NickRimmer/RedBot/README.md

# RedBot

Please check [this site](https://www.redbot.info/pages/en/welcome/) for more information.

Более подробную информацию вы можете найти [на этом сайте](https://www.redbot.info/pages/en/welcome/).
