NickRimmer/RedBot/printers/re_d_bot_v1/mods/mgn12_y_axis/main.stl

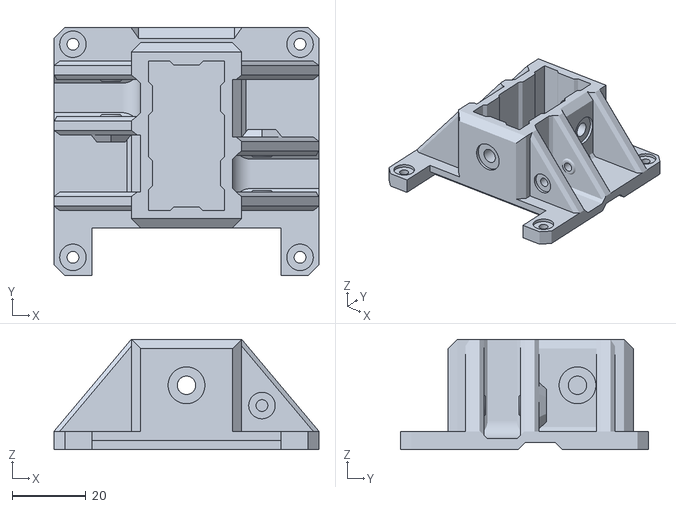
[picture p1: CAD file, 2018-05-23]
printers/re_d_bot_v1/mods/mgn12_y_axis/main.stl
72.0 x 67.5 x 30.0
