NickRimmer/RedBot/printers/re_d_bot_v1/base/1_Endstop_x_flange.STL

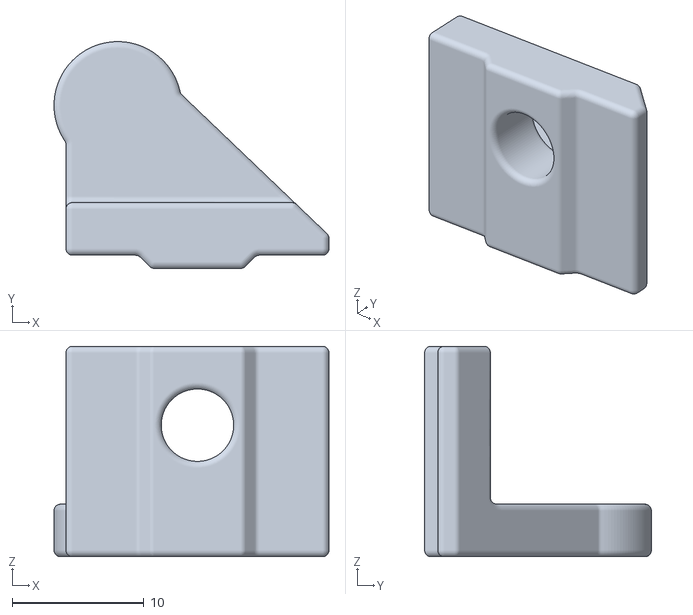
[picture p2: CAD file, 2018-05-17]
printers/re_d_bot_v1/base/1_Endstop_x_flange.STL
20.9 x 17.2 x 16.0
