NickRimmer/RedBot/printers/re_d_bot_v1/base/head/E3Dv6_holder_part2.STL

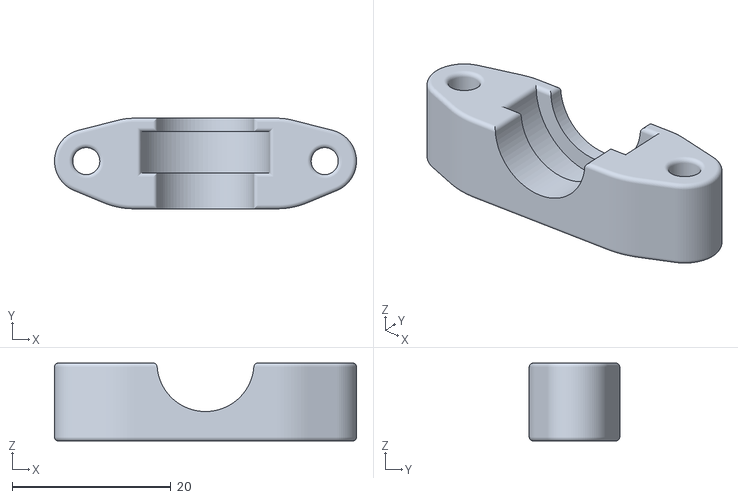
[picture p3: CAD file, 2018-05-17]
printers/re_d_bot_v1/base/head/E3Dv6_holder_part2.STL
38.0 x 11.4 x 9.80
