NickRimmer/RedBot/printers/re_d_bot_v1/mods/mgn12_y_axis/top.stl

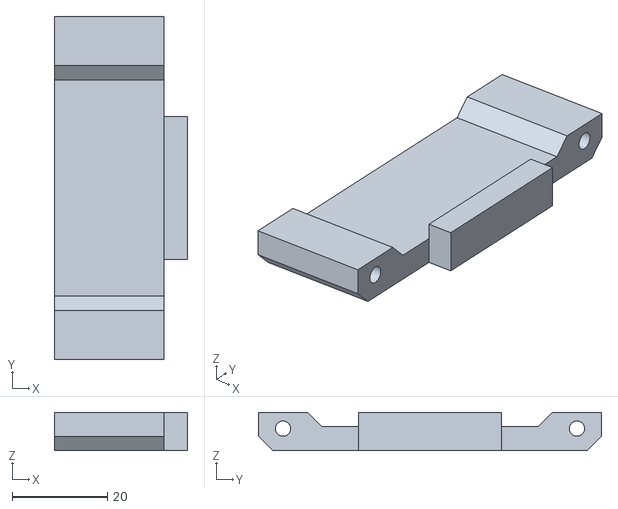
[picture p4: CAD file, 2018-05-23]
printers/re_d_bot_v1/mods/mgn12_y_axis/top.stl
28.0 x 72.0 x 8.00
