NickRimmer/RedBot/printers/re_d_bot_v1/mods/re_x_carriage/Base_back_1.STL

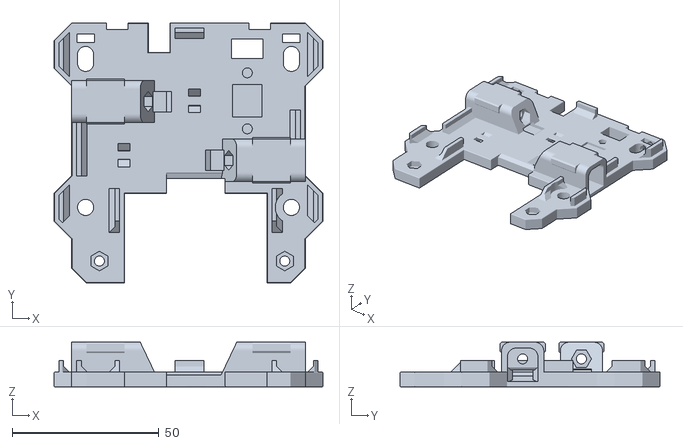
[picture p5: CAD file, 2018-05-20]
printers/re_d_bot_v1/mods/re_x_carriage/Base_back_1.STL
91.5 x 88.5 x 15.2
