NickRimmer/RedBot/printers/re_d_bot_v1/base/4_Triangle_table_plate_mirrored.STL

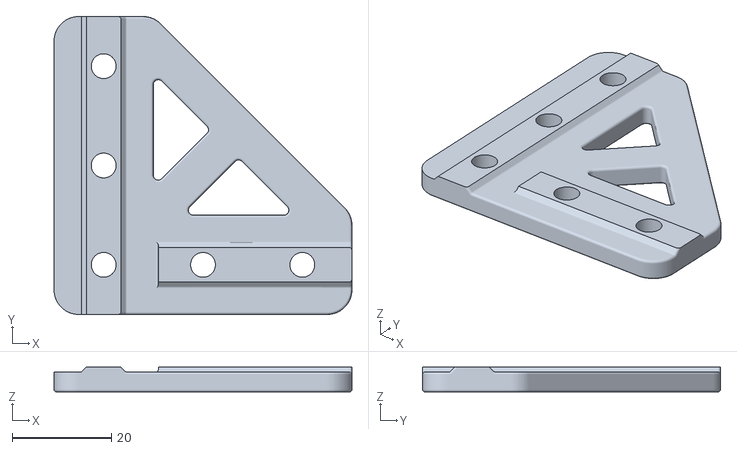
[picture p6: CAD file, 2018-05-17]
printers/re_d_bot_v1/base/4_Triangle_table_plate_mirrored.STL
60.0 x 60.0 x 5.00
