NickRimmer/RedBot/printers/re_d_bot_v1/base/head/Carriage_base_front.STL

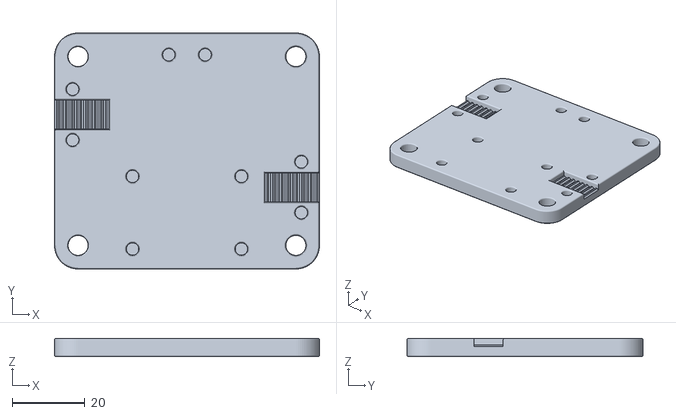
[picture p7: CAD file, 2018-05-17]
printers/re_d_bot_v1/base/head/Carriage_base_front.STL
73.0 x 65.0 x 5.00
