NickRimmer/RedBot/printers/re_d_bot_v1/mods/mgn12_y_axis/back.stl

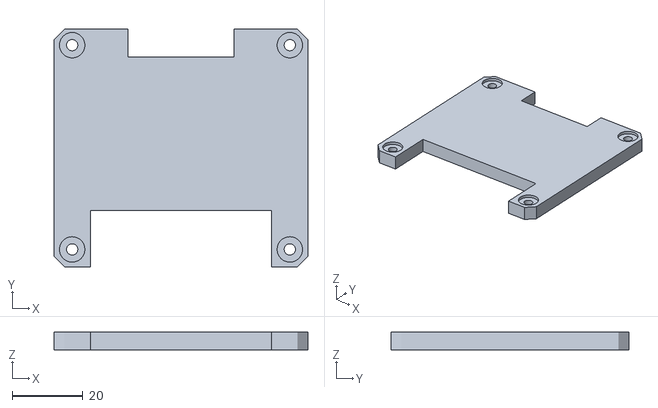
[picture p8: CAD file, 2018-05-23]
printers/re_d_bot_v1/mods/mgn12_y_axis/back.stl
72.0 x 67.5 x 5.00
