NickRimmer/RedBot/printers/re_d_bot_v1/mods/re_x_carriage/fan_duct_filament_nozzle_left.sldprt

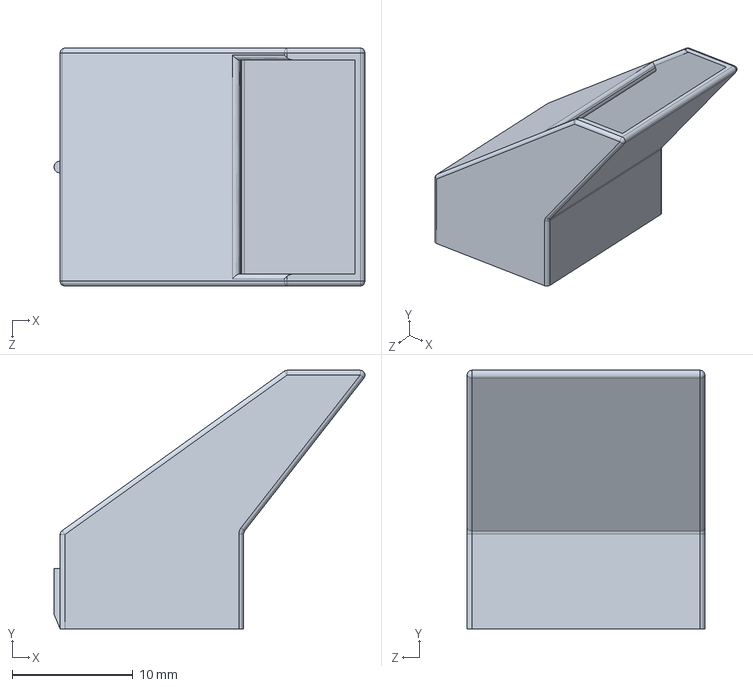
[picture p9: CAD file, 2018-05-20]
printers/re_d_bot_v1/mods/re_x_carriage/fan_duct_filament_nozzle_left.sldprt
25.7 x 21.4 x 19.7 mm
