NickRimmer/RedBot/printers/re_d_bot_v1/base/1_Endstop_z_base_part1.STL

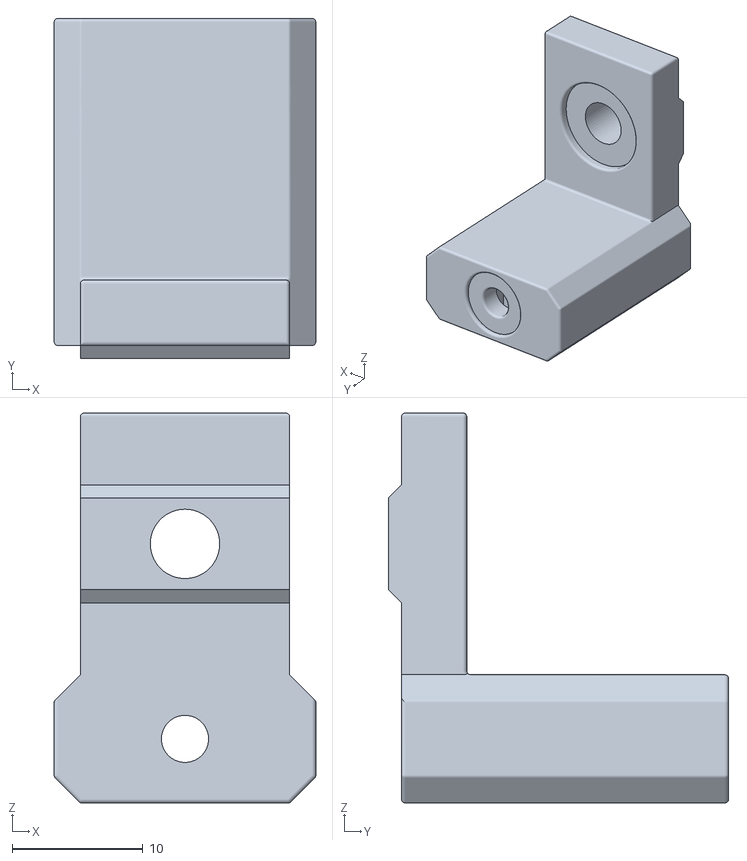
[picture p10: CAD file, 2018-05-17]
printers/re_d_bot_v1/base/1_Endstop_z_base_part1.STL
20.0 x 26.0 x 29.8
