NickRimmer/RedBot/printers/re_d_bot_v1/base/head/Decorative_Cover_front_part3.STL

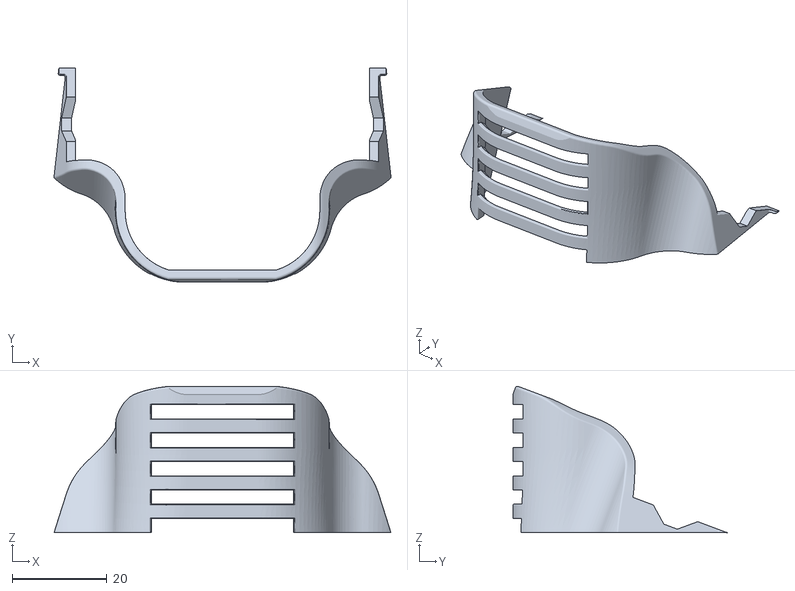
[picture p11: CAD file, 2018-05-17]
printers/re_d_bot_v1/base/head/Decorative_Cover_front_part3.STL
71.0 x 45.2 x 30.9
