NickRimmer/RedBot/printers/re_d_bot_v1/mods/mgn12_y_axis/bottom.stl

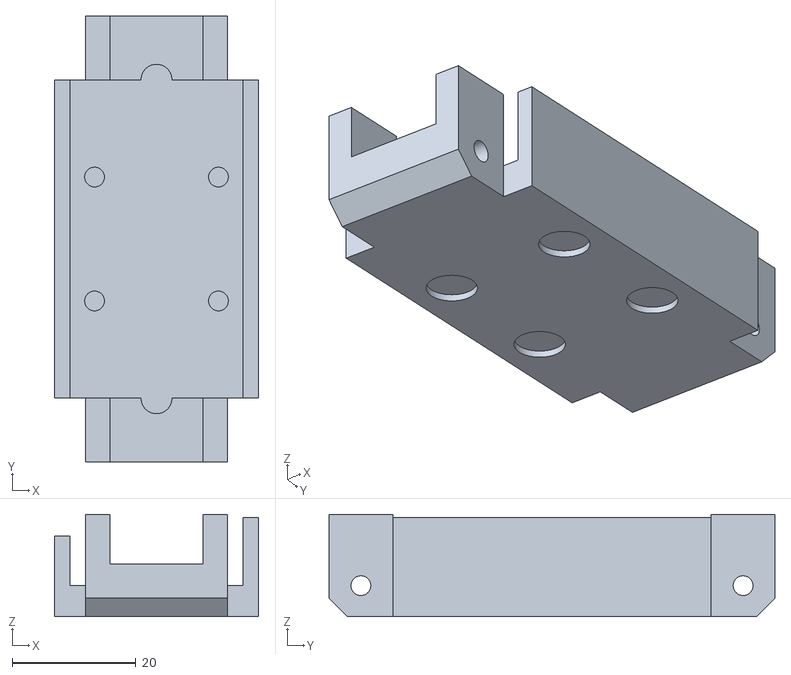
[picture p12: CAD file, 2018-05-23]
printers/re_d_bot_v1/mods/mgn12_y_axis/bottom.stl
33.0 x 72.0 x 16.5
