NickRimmer/RedBot/printers/re_d_bot_v1/mods/re_x_carriage/Belt_holder_back_2.STL

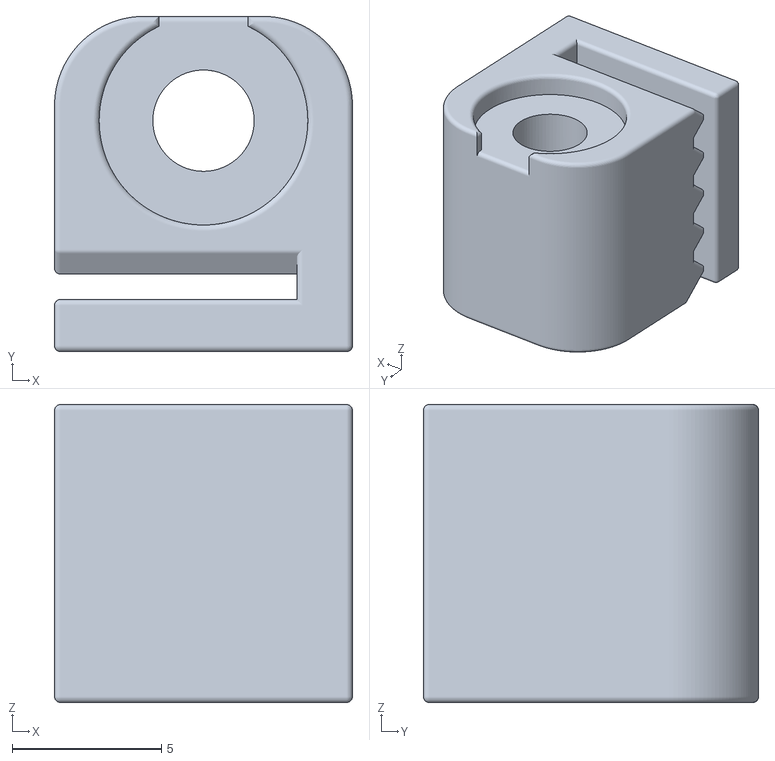
[picture p13: CAD file, 2018-05-20]
printers/re_d_bot_v1/mods/re_x_carriage/Belt_holder_back_2.STL
10.00 x 11.2 x 10.00
