NickRimmer/RedBot/printers/re_d_bot_v1/base/2_Z_motor_mount.STL

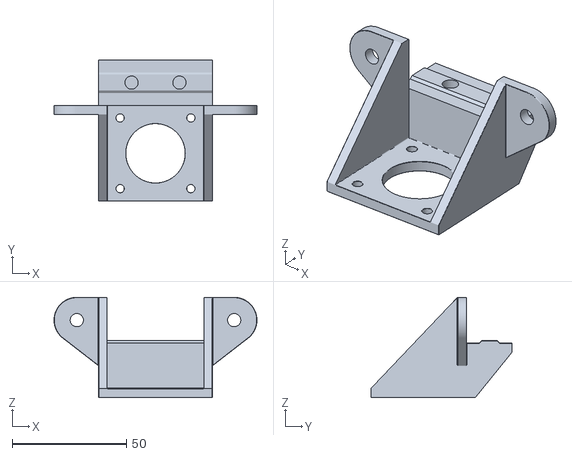
[picture p14: CAD file, 2018-05-17]
printers/re_d_bot_v1/base/2_Z_motor_mount.STL
89.0 x 62.0 x 44.0
