NickRimmer/RedBot/printers/re_d_bot_v1/base/head/Fan_duct_filament_V2.STL

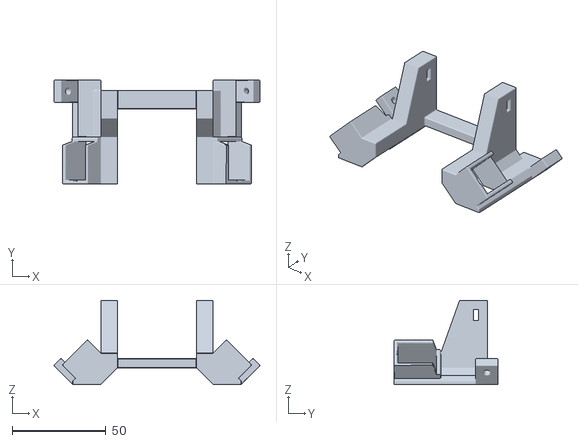
[picture p15: CAD file, 2018-05-17]
printers/re_d_bot_v1/base/head/Fan_duct_filament_V2.STL
110.0 x 55.5 x 45.0
