NickRimmer/RedBot/printers/re_d_bot_v1/base/4_Guide_Z.STL

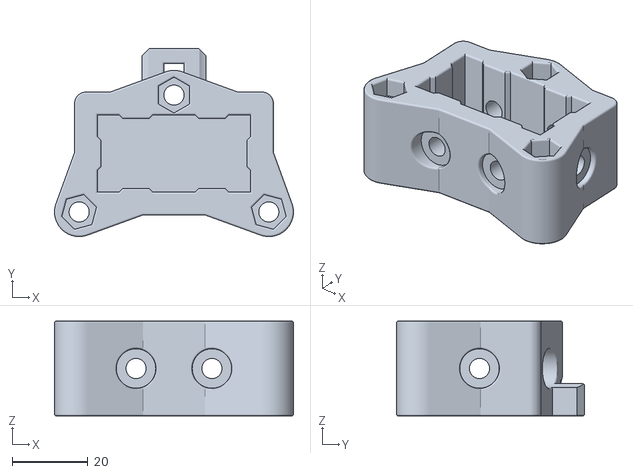
[picture p16: CAD file, 2018-05-17]
printers/re_d_bot_v1/base/4_Guide_Z.STL
63.0 x 49.6 x 25.0
