NickRimmer/RedBot/printers/re_d_bot_v1/base/head/fan_duct_filament_V2_nozzle.sldprt

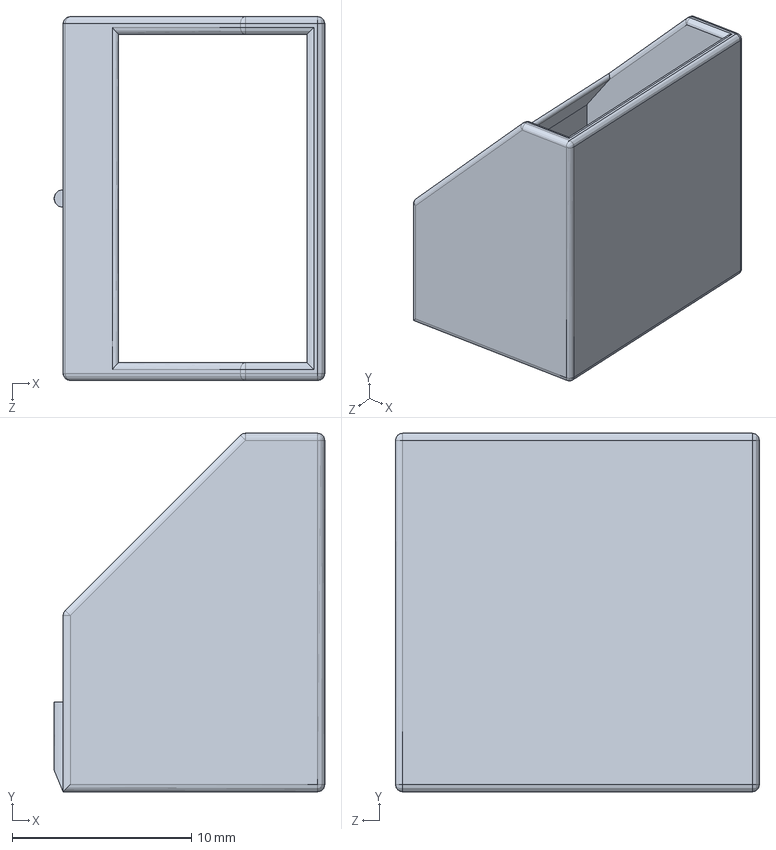
[picture p17: CAD file, 2018-05-17]
printers/re_d_bot_v1/base/head/fan_duct_filament_V2_nozzle.sldprt
15.1 x 20.0 x 20.3 mm
