NickRimmer/RedBot/printers/re_d_bot_v1/base/1_Guide_Y_right.STL

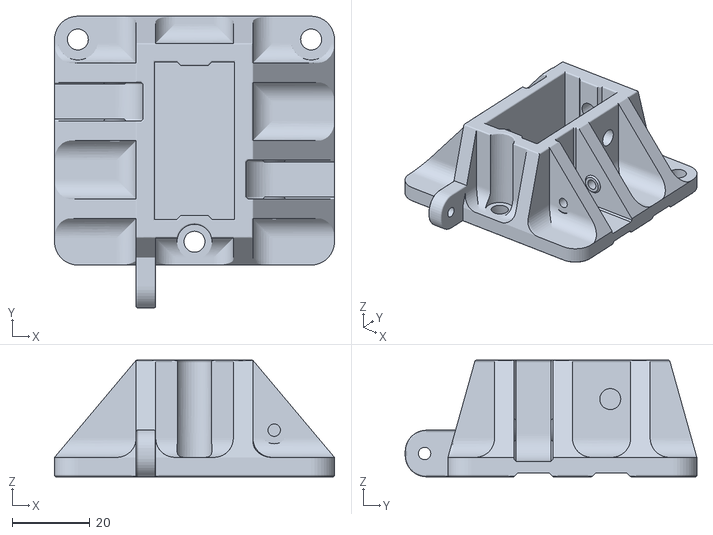
[picture p18: CAD file, 2018-05-17]
printers/re_d_bot_v1/base/1_Guide_Y_right.STL
72.0 x 75.0 x 30.0
