NickRimmer/RedBot/printers/re_d_bot_v1/base/head/Carriage_base_back.STL

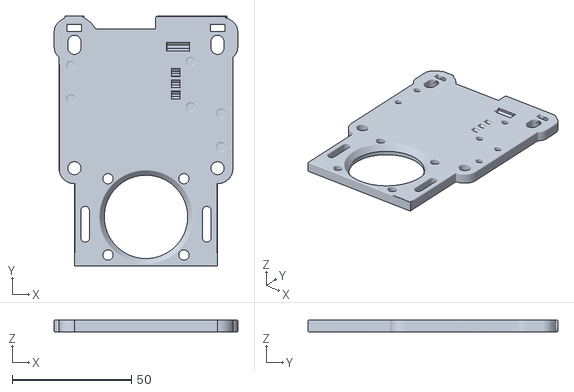
[picture p19: CAD file, 2018-05-17]
printers/re_d_bot_v1/base/head/Carriage_base_back.STL
77.0 x 104.8 x 5.00
