NickRimmer/RedBot/printers/re_d_bot_v1/base/22_(IF_REQUIRED)_Bearing_Shim.stl

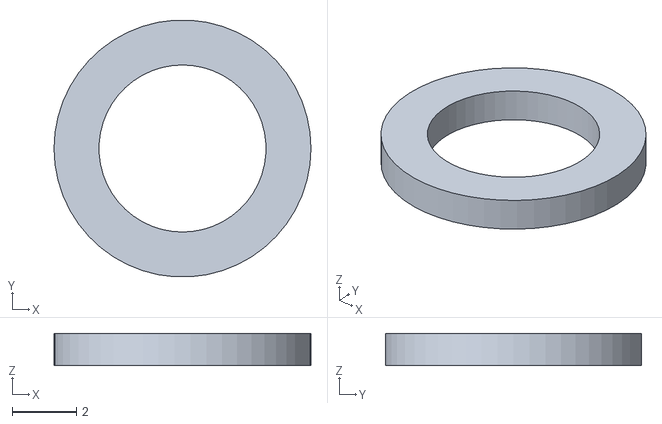
[picture p21: CAD file, 2018-05-17]
printers/re_d_bot_v1/base/22_(IF_REQUIRED)_Bearing_Shim.stl
8.00 x 7.98 x 1
