NickRimmer/RedBot/printers/re_d_bot_v1/mods/re_x_carriage/Endstop_x_part2_1.STL

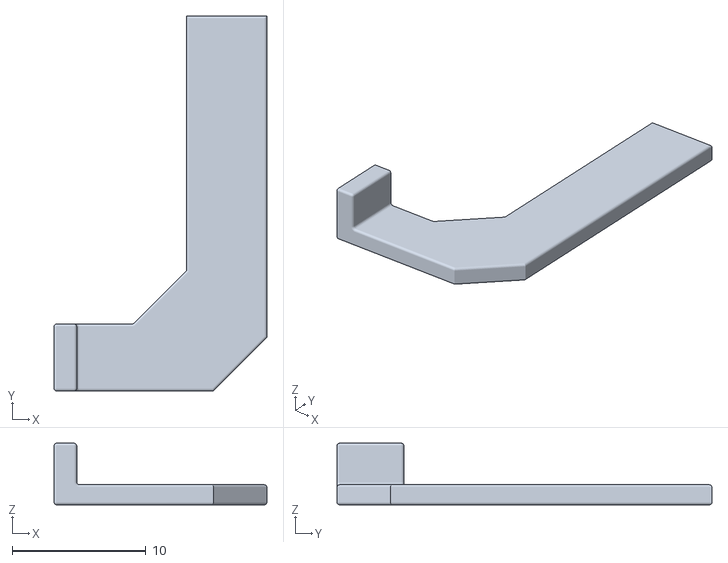
[picture p22: CAD file, 2018-05-20]
printers/re_d_bot_v1/mods/re_x_carriage/Endstop_x_part2_1.STL
15.9 x 28.0 x 4.60
