NickRimmer/RedBot/printers/re_d_bot_v1/base/1_Extruder_motor_holder.STL

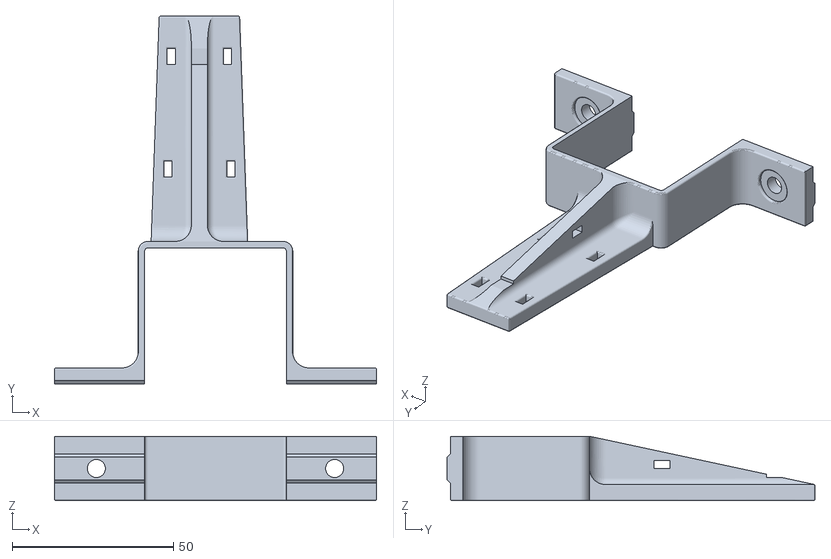
[picture p23: CAD file, 2018-05-17]
printers/re_d_bot_v1/base/1_Extruder_motor_holder.STL
100.0 x 114.2 x 20.0
