NickRimmer/RedBot/printers/re_d_bot_v1/mods/re_x_carriage/Fan_duct_filament_holder_1.STL

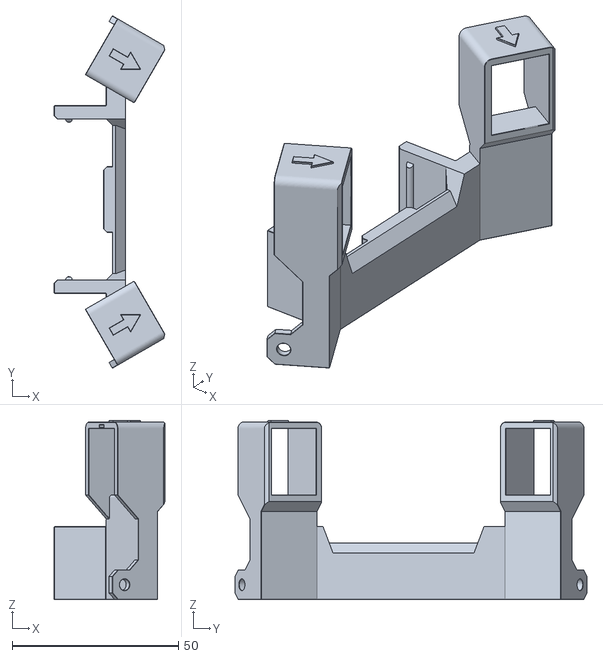
[picture p25: CAD file, 2018-05-20]
printers/re_d_bot_v1/mods/re_x_carriage/Fan_duct_filament_holder_1.STL
33.3 x 105.7 x 53.9
