NickRimmer/RedBot/printers/re_d_bot_v1/base/1_Endstop_y_bracket.STL

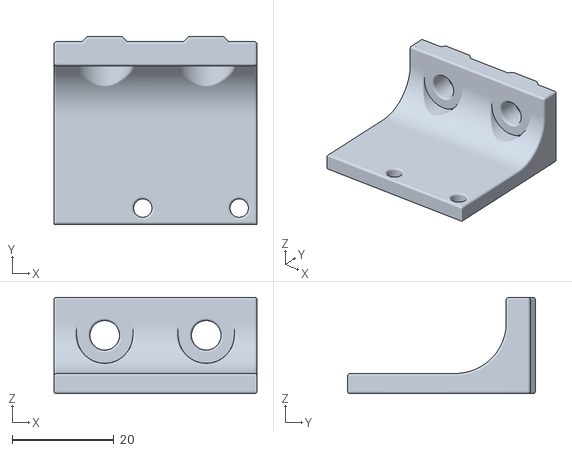
[picture p26: CAD file, 2018-05-17]
printers/re_d_bot_v1/base/1_Endstop_y_bracket.STL
40.0 x 37.0 x 19.0
