NickRimmer/RedBot/printers/re_d_bot_v1/base/head/Decorative_Cover_rear.STL

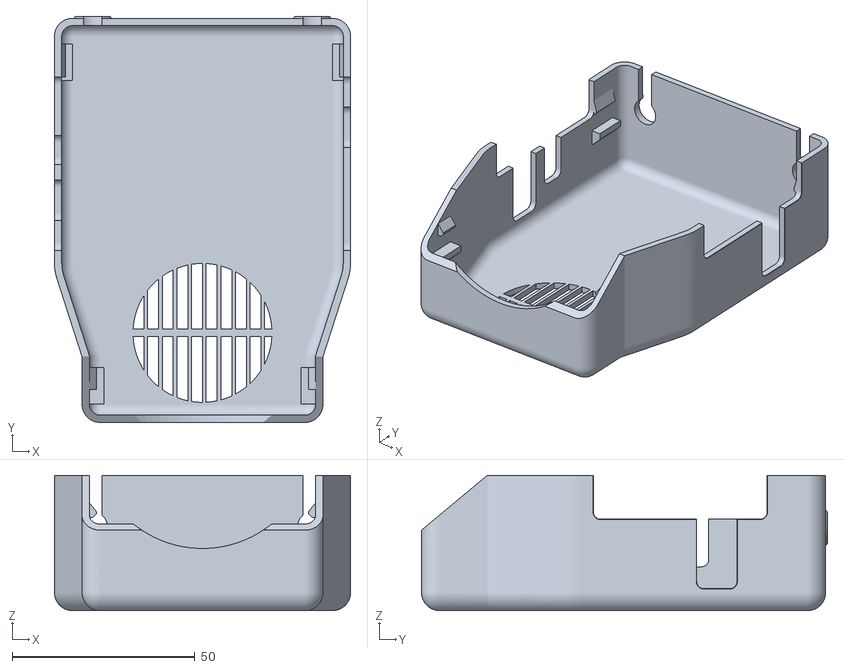
[picture p27: CAD file, 2018-05-17]
printers/re_d_bot_v1/base/head/Decorative_Cover_rear.STL
81.0 x 111.0 x 37.0
