NickRimmer/RedBot/printers/re_d_bot_v1/mods/re_x_carriage/Cover_top_1.STL

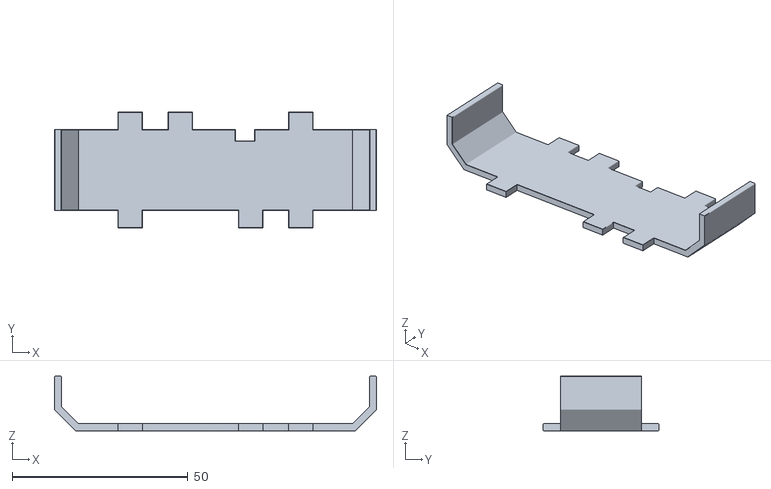
[picture p28: CAD file, 2018-05-20]
printers/re_d_bot_v1/mods/re_x_carriage/Cover_top_1.STL
91.5 x 33.0 x 15.5
