NickRimmer/RedBot/printers/re_d_bot_v1/base/head/updated_Decorative_Cover_front_part1_no_title.STL

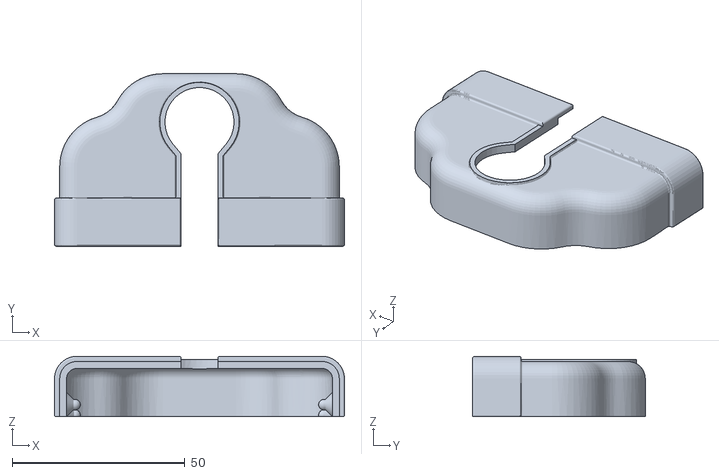
[picture p30: CAD file, 2018-05-17]
printers/re_d_bot_v1/base/head/updated_Decorative_Cover_front_part1_no_title.STL
84.0 x 50.0 x 17.5
