NickRimmer/RedBot/printers/re_d_bot_v1/mods/re_x_carriage/fan_duct_filament_nozzle_right.sldprt

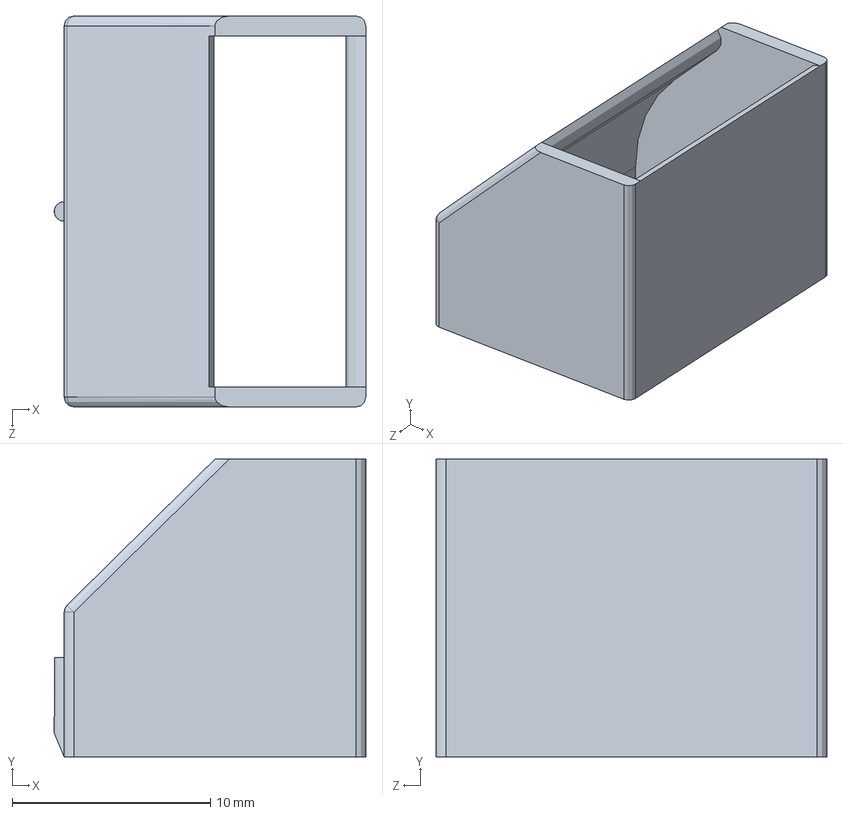
[picture p31: CAD file, 2018-05-20]
printers/re_d_bot_v1/mods/re_x_carriage/fan_duct_filament_nozzle_right.sldprt
15.7 x 15.0 x 19.7 mm
