NickRimmer/RedBot/printers/re_d_bot_v1/base/3_Bed_holder_part2.STL

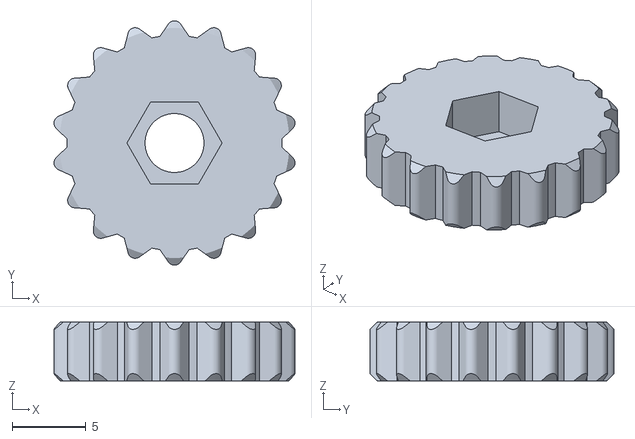
[picture p32: CAD file, 2018-05-17]
printers/re_d_bot_v1/base/3_Bed_holder_part2.STL
16.4 x 16.6 x 4.00
