NickRimmer/RedBot/printers/re_d_bot_v1/base/head/E3Dv6_holder_part1.STL

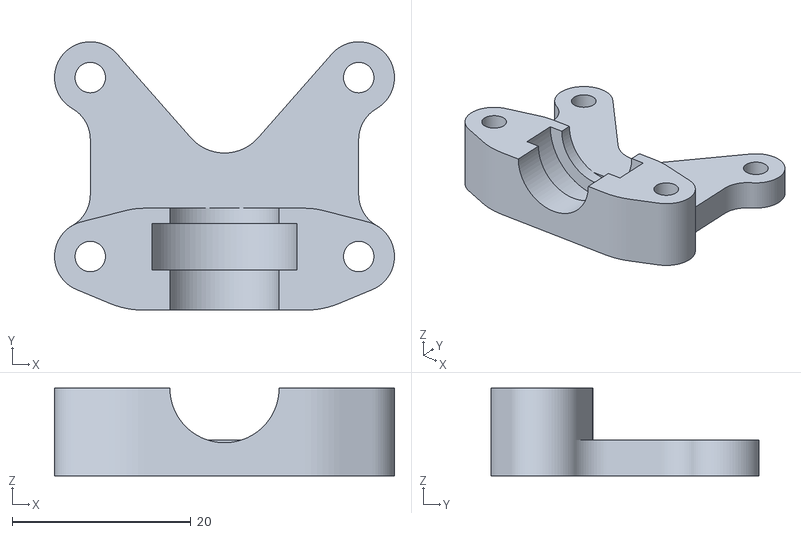
[picture p33: CAD file, 2018-05-17]
printers/re_d_bot_v1/base/head/E3Dv6_holder_part1.STL
38.0 x 30.0 x 9.80
