NickRimmer/RedBot/printers/re_d_bot_v1/base/2_Guide_Y_part2.STL

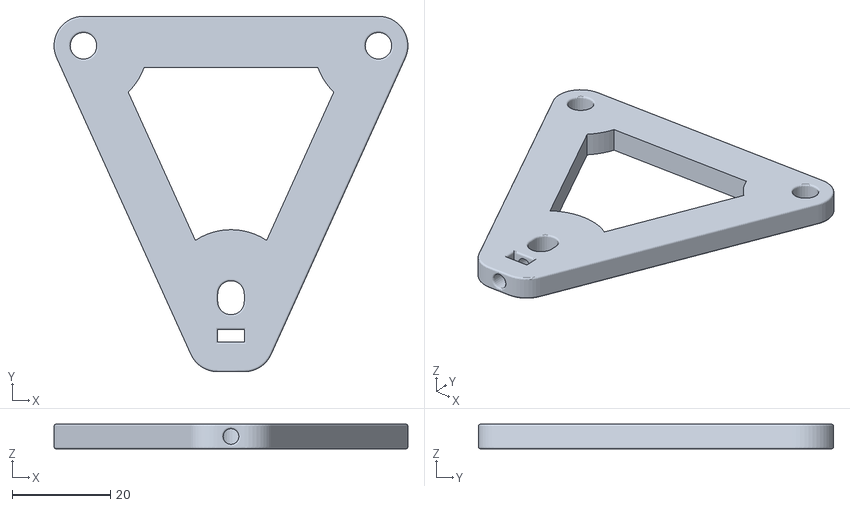
[picture p34: CAD file, 2018-05-17]
printers/re_d_bot_v1/base/2_Guide_Y_part2.STL
72.0 x 72.3 x 5.00
