NickRimmer/RedBot/printers/re_d_bot_v1/base/head/PTFE_Guide.STL

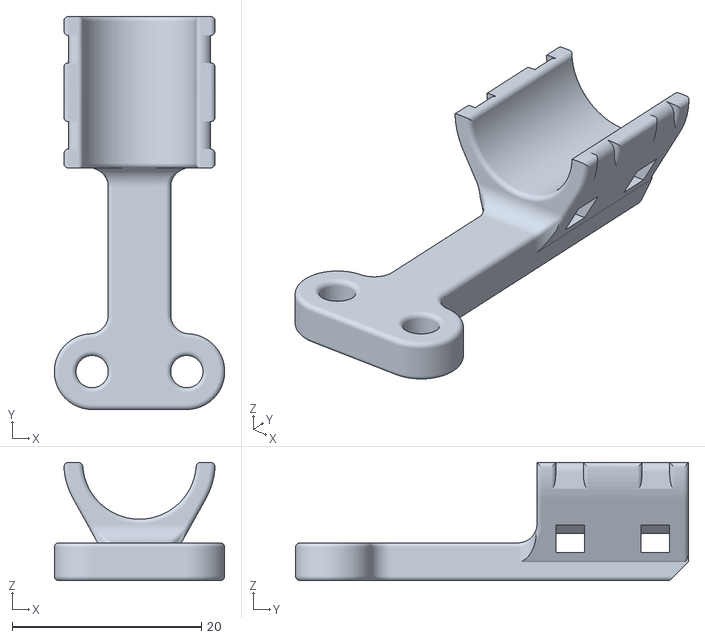
[picture p35: CAD file, 2018-05-17]
printers/re_d_bot_v1/base/head/PTFE_Guide.STL
18.0 x 41.5 x 12.5
