NickRimmer/RedBot/printers/re_d_bot_v1/mods/re_x_carriage/Cover_front_1.STL

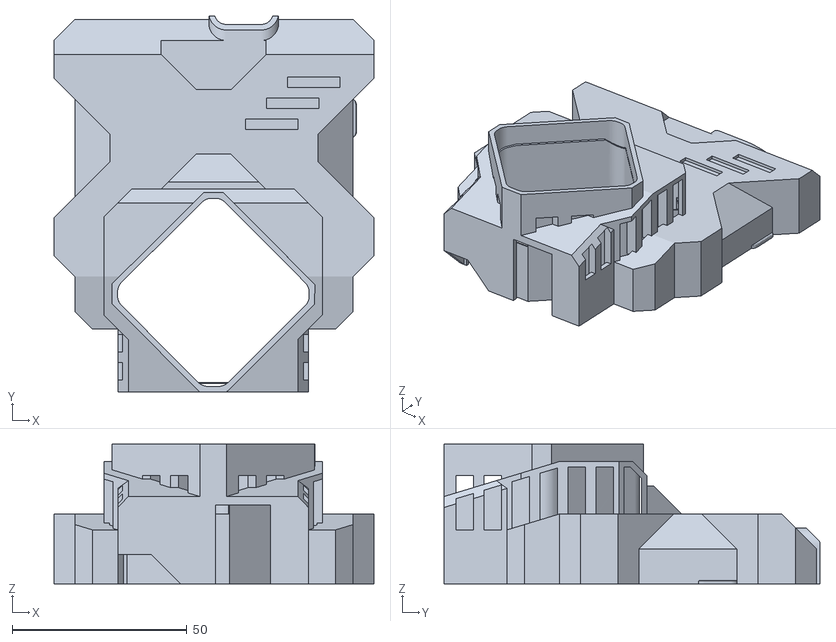
[picture p36: CAD file, 2018-05-20]
printers/re_d_bot_v1/mods/re_x_carriage/Cover_front_1.STL
91.5 x 107.5 x 40.0
