NickRimmer/RedBot/printers/re_d_bot_v1/base/head/Decorative_Cover_front_part1.STL

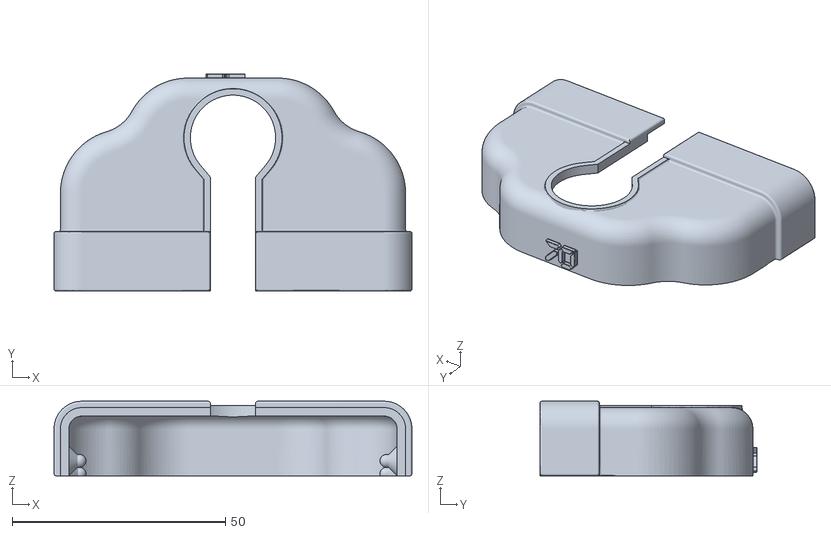
[picture p37: CAD file, 2018-05-17]
printers/re_d_bot_v1/base/head/Decorative_Cover_front_part1.STL
84.0 x 51.0 x 17.5
