NickRimmer/RedBot/printers/re_d_bot_v1/base/1_Guide_Y_left.STL

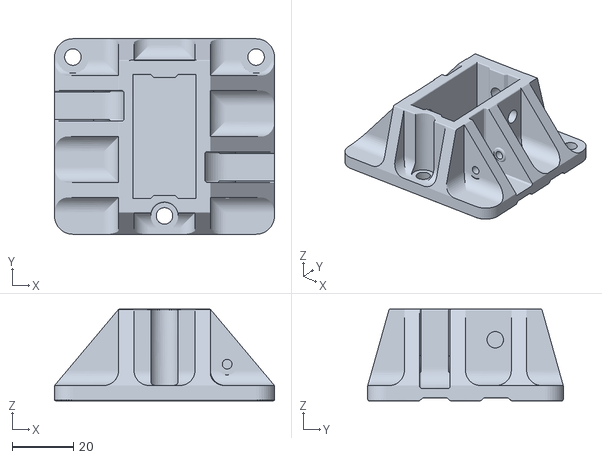
[picture p38: CAD file, 2018-05-17]
printers/re_d_bot_v1/base/1_Guide_Y_left.STL
72.0 x 64.0 x 30.0
