NickRimmer/RedBot/printers/re_d_bot_v1/base/head/Belt_holder.STL

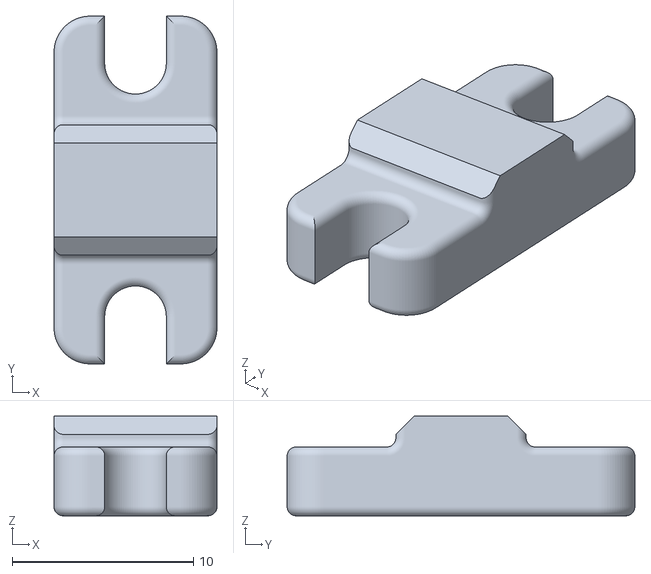
[picture p39: CAD file, 2018-05-17]
printers/re_d_bot_v1/base/head/Belt_holder.STL
9.00 x 19.2 x 5.50
