NickRimmer/RedBot/printers/re_d_bot_v1/mods/re_x_carriage/Wheel_spacer_normal_8.STL

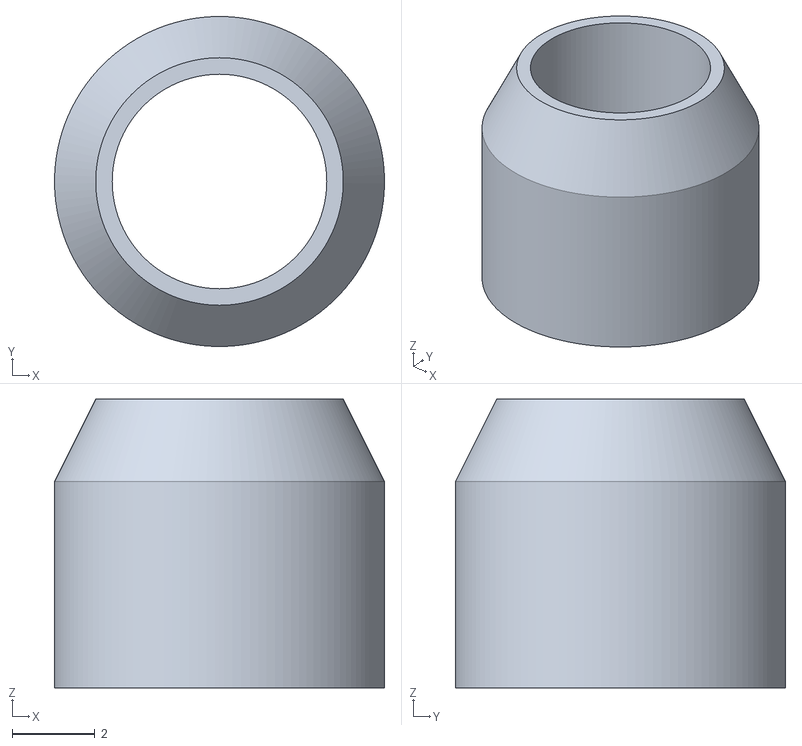
[picture p40: CAD file, 2018-05-20]
printers/re_d_bot_v1/mods/re_x_carriage/Wheel_spacer_normal_8.STL
8.00 x 8.00 x 7.00
