NickRimmer/RedBot/printers/re_d_bot_v1/base/1_Rear_corner_left.STL

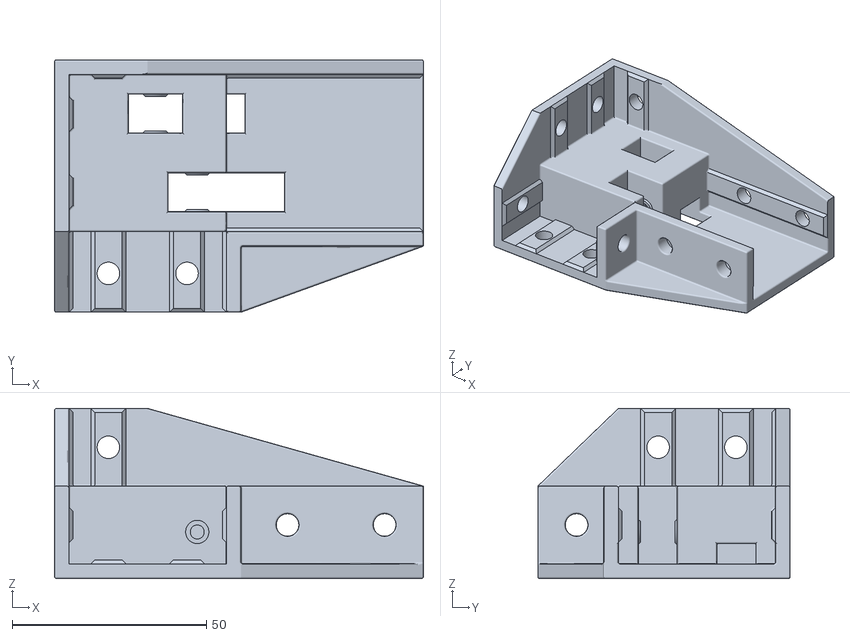
[picture p41: CAD file, 2018-05-17]
printers/re_d_bot_v1/base/1_Rear_corner_left.STL
95.0 x 65.0 x 43.8
