NickRimmer/RedBot/printers/re_d_bot_v1/base/head/Belt_tensioner_end.STL

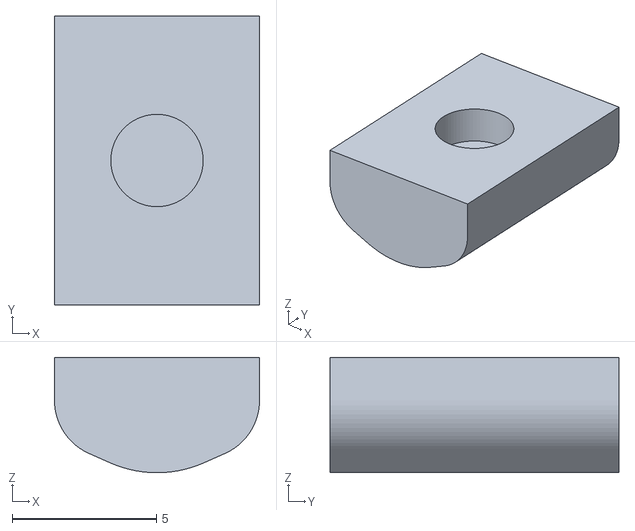
[picture p42: CAD file, 2018-05-17]
printers/re_d_bot_v1/base/head/Belt_tensioner_end.STL
7.10 x 10.0 x 4.00
