NickRimmer/RedBot/printers/re_d_bot_v1/mods/re_x_carriage/Wheel_spacer_mini_8.STL

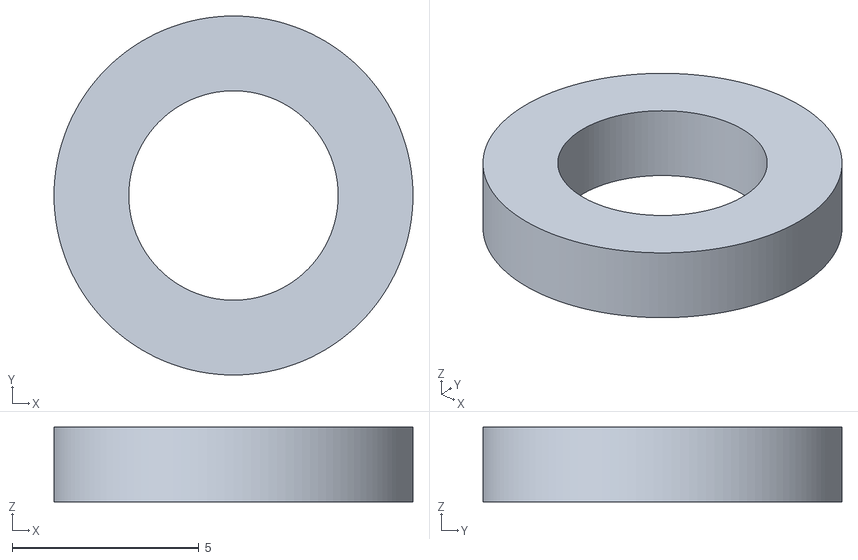
[picture p43: CAD file, 2018-05-20]
printers/re_d_bot_v1/mods/re_x_carriage/Wheel_spacer_mini_8.STL
9.60 x 9.60 x 2.00
