NickRimmer/RedBot/printers/re_d_bot_v1/base/head/Fan_duct_radiator.STL

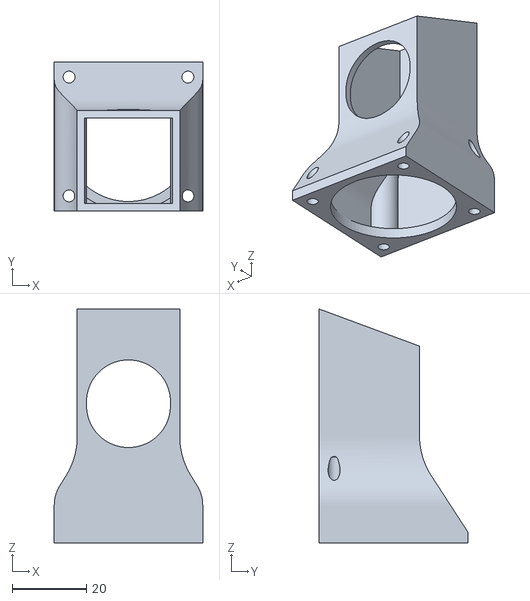
[picture p44: CAD file, 2018-05-17]
printers/re_d_bot_v1/base/head/Fan_duct_radiator.STL
40.0 x 40.0 x 63.0
