NickRimmer/RedBot/printers/re_d_bot_v1/mods/re_x_carriage/Endstop_x_part1_1.STL

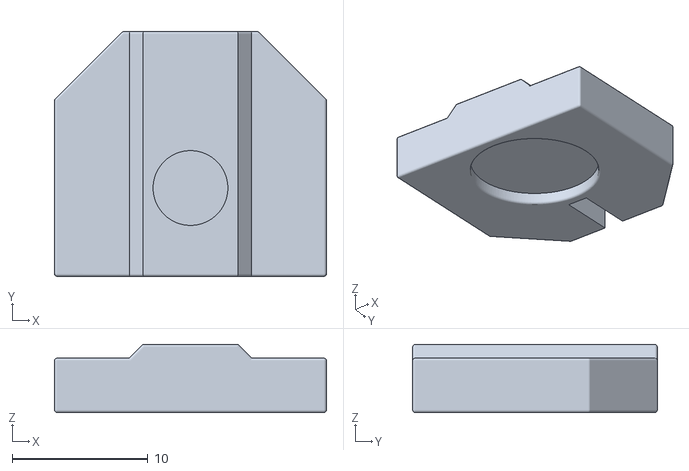
[picture p45: CAD file, 2018-05-20]
printers/re_d_bot_v1/mods/re_x_carriage/Endstop_x_part1_1.STL
20.0 x 18.0 x 5.00
