NickRimmer/RedBot/printers/re_d_bot_v1/mods/re_x_carriage/Cover_front_decor_3.STL

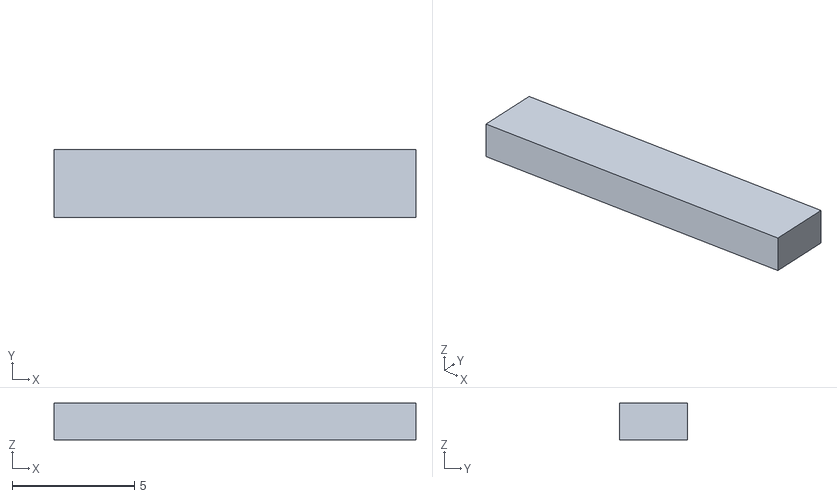
[picture p47: CAD file, 2018-05-20]
printers/re_d_bot_v1/mods/re_x_carriage/Cover_front_decor_3.STL
14.8 x 2.80 x 1.50
