NickRimmer/RedBot/printers/re_d_bot_v1/base/head/updated_Decorative_Cover_front_part2_no_title.STL

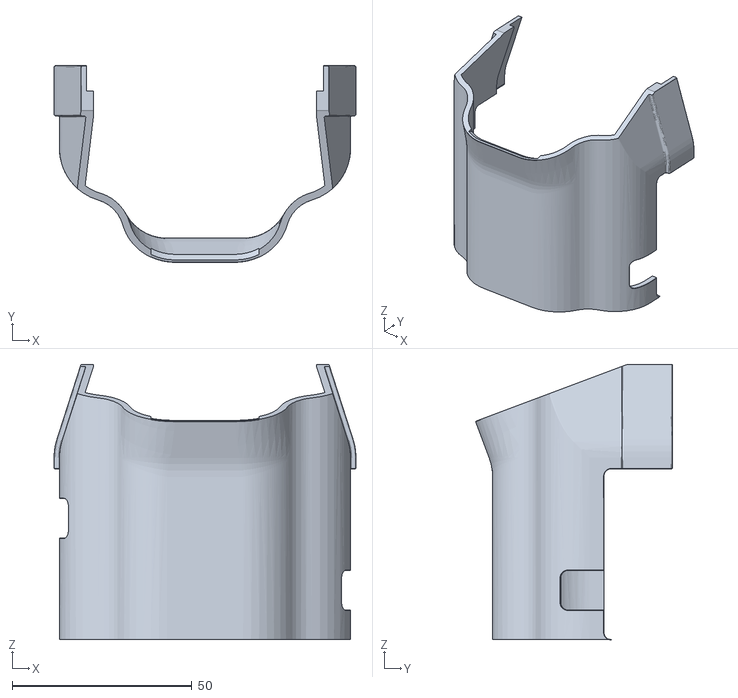
[picture p48: CAD file, 2018-05-17]
printers/re_d_bot_v1/base/head/updated_Decorative_Cover_front_part2_no_title.STL
84.0 x 54.7 x 76.6
