NickRimmer/RedBot/printers/re_d_bot_v1/mods/re_x_carriage/Motor_holder_1.STL

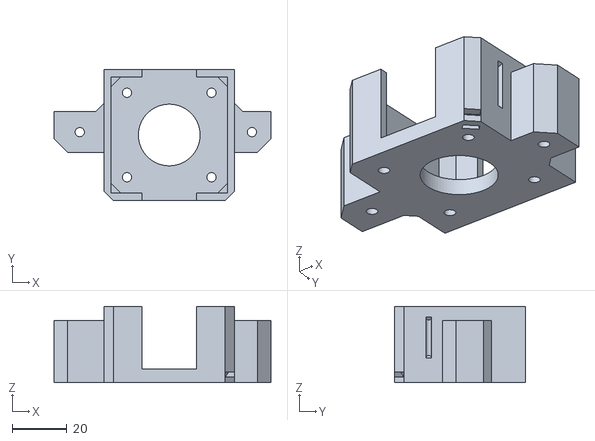
[picture p49: CAD file, 2018-05-20]
printers/re_d_bot_v1/mods/re_x_carriage/Motor_holder_1.STL
79.6 x 48.0 x 28.0
