NickRimmer/RedBot/printers/re_d_bot_v1/base/1_Front_corner_right.STL

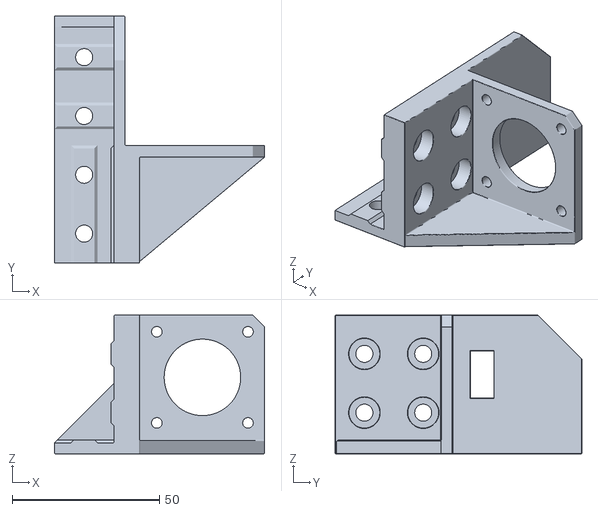
[picture p50: CAD file, 2018-05-17]
printers/re_d_bot_v1/base/1_Front_corner_right.STL
71.5 x 84.0 x 47.2
