NickRimmer/RedBot/printers/re_d_bot_v1/mods/re_x_carriage/Wires_guide_1.STL

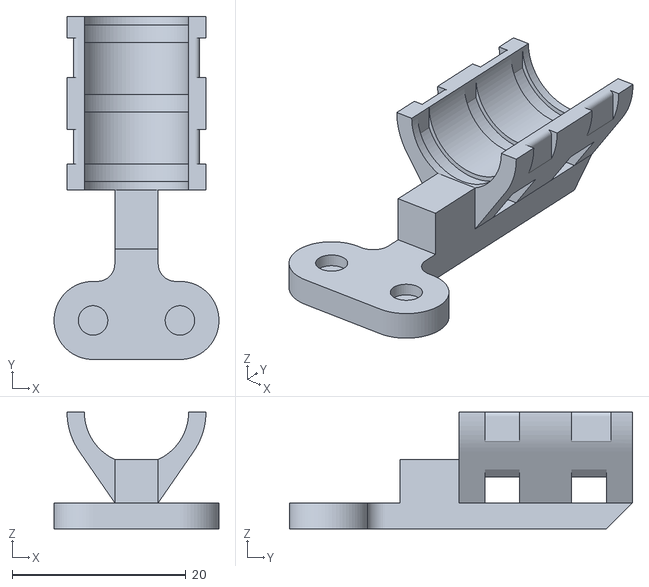
[picture p51: CAD file, 2018-05-20]
printers/re_d_bot_v1/mods/re_x_carriage/Wires_guide_1.STL
19.0 x 39.5 x 13.5
