NickRimmer/RedBot/printers/re_d_bot_v1/base/head/Belt_tensioner_base.STL

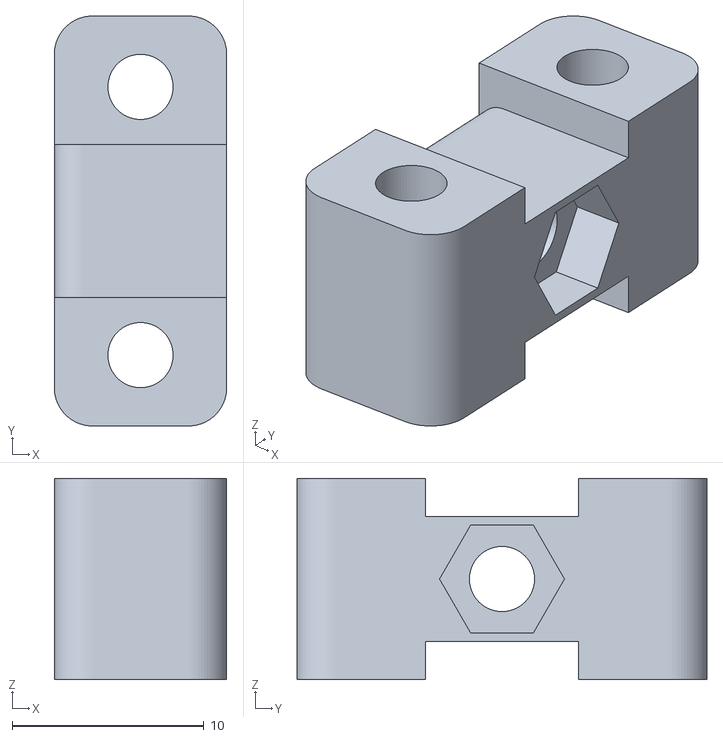
[picture p52: CAD file, 2018-05-17]
printers/re_d_bot_v1/base/head/Belt_tensioner_base.STL
9.00 x 21.4 x 10.5
