NickRimmer/RedBot/printers/re_d_bot_v1/base/3_Bed_holder_part1.STL

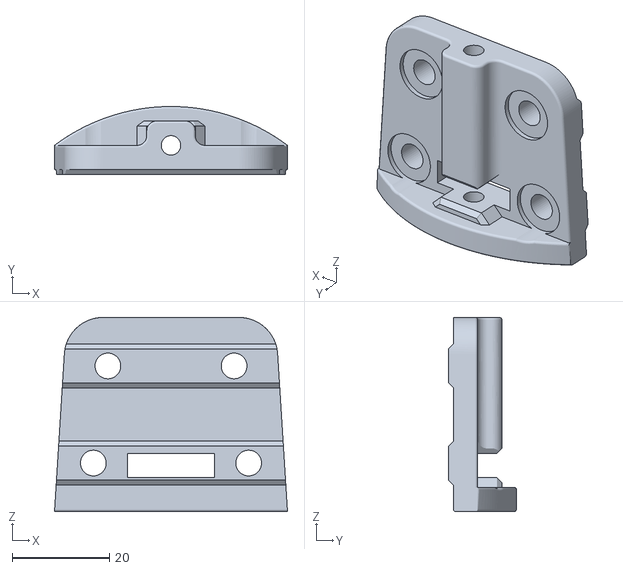
[picture p53: CAD file, 2018-05-17]
printers/re_d_bot_v1/base/3_Bed_holder_part1.STL
48.0 x 14.0 x 40.0
