NickRimmer/RedBot/printers/re_d_bot_v1/base/1_Endstop_z_bracket.STL

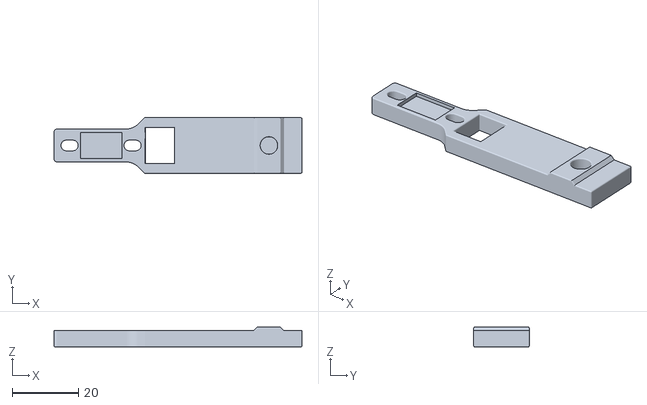
[picture p54: CAD file, 2018-05-17]
printers/re_d_bot_v1/base/1_Endstop_z_bracket.STL
75.0 x 16.8 x 6.00
