NickRimmer/RedBot/printers/re_d_bot_v1/base/18_Corner_bracket.STL

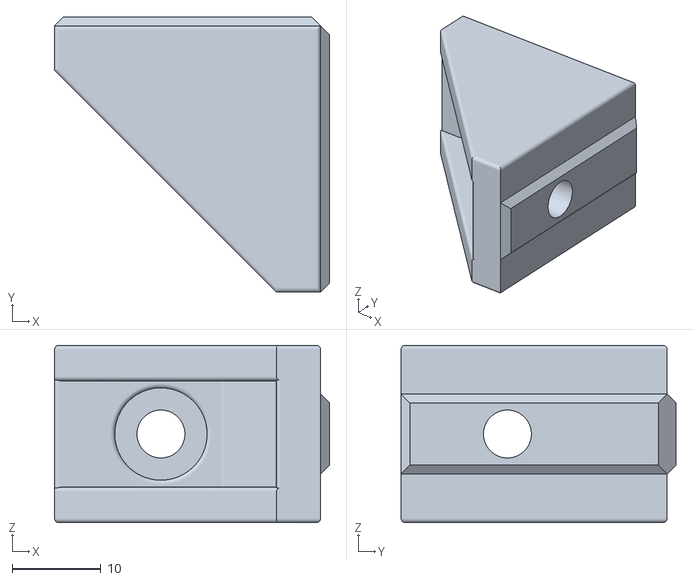
[picture p55: CAD file, 2018-05-17]
printers/re_d_bot_v1/base/18_Corner_bracket.STL
31.0 x 31.0 x 20.0
