NickRimmer/RedBot/printers/re_d_bot_v1/base/1_Endstop_z_base_part2.STL

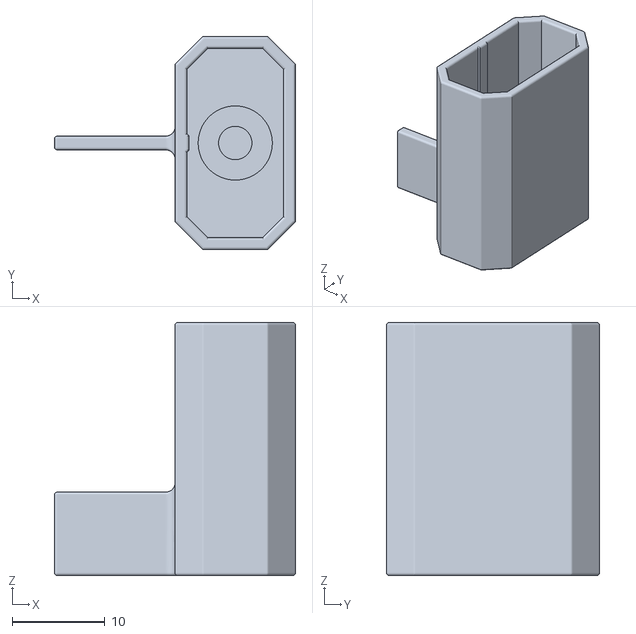
[picture p56: CAD file, 2018-05-17]
printers/re_d_bot_v1/base/1_Endstop_z_base_part2.STL
26.0 x 23.0 x 27.3
