NickRimmer/RedBot/(list of files, cad)

Other CAD files:
printers/re_d_bot_v1/mods/re_x_carriage/Fan_duct_filament_nozzle_left_1.STL
printers/re_d_bot_v1/mods/re_x_carriage/Cover_back_1.STL
printers/re_d_bot_v1/base/head/Fan_duct_filament_V2_nozzle_x2.STL
printers/re_d_bot_v1/mods/re_x_carriage/Fan_duct_filament_nozzle_right_1.STL
printers/re_d_bot_v1/base/4_Triangle_table_plate.STL
printers/re_d_bot_v1/mods/re_x_carriage/Belt_holder_front_2.STL
printers/re_d_bot_v1/base/2_Triangle_bottom_plate.STL
printers/re_d_bot_v1/base/head/Endstop_X.STL
printers/re_d_bot_v1/base/1_Rear_corner_right.STL
printers/re_d_bot_v1/base/head/Decorative_Cover_front_part2.STL
printers/re_d_bot_v1/base/32_Wheel_spacer.STL
printers/re_d_bot_v1/base/2_Lead_screw_holder_M8.STL
