NickRimmer/RedBot/printers/re_d_bot_v1/mods/mgn12_y_axis/README.md

# Re-D-Bot (v1) modification.






More information:
- [Русский](https://www.redbot.info/pages/ru/printers/v1/mods/list/mgn12_y_axis/)
