NickRimmer/RedBot/(threads)

Thread 1 (2018-07-04):

Исходники

altSoftLLC, 2018-07-04:
Можете выложить в репозитарий исходники. Я так понимаю, что всё сделано во Fusion 360.

Редактировать STL не всегда удобно.

NickRimmer, 2018-09-11:
Всего пара деталей во фьюжене сделана. Некоторыми исходниками мы уже делились, остальные не пока выкладываем.
