NickRimmer/RedBot/(commit log)

2018-05-17 re-d-bot 3d models
    [18_Corner_bracket.STL, 1_Endstop_x_flange.STL, 1_Endstop_y_bracket.STL, 1_Endstop_z_base_part1.STL, 1_Endstop_z_base_part2.STL, 1_Endstop_z_bracket.STL, 1_Extruder_motor_holder.STL, 1_Front_corner_left.STL]
2018-05-20 paths update
    [18_Corner_bracket.STL, 1_Endstop_x_flange.STL, 1_Endstop_y_bracket.STL, 1_Endstop_z_base_part1.STL, 1_Endstop_z_base_part2.STL, 1_Endstop_z_bracket.STL, 1_Extruder_motor_holder.STL, 1_Front_corner_left.STL]
2018-05-23 mgn12_x_axis upload
    [back.stl, bottom.stl, main.stl, top.stl]
